exzombie/motokurnikator/door_mechanism.jpg

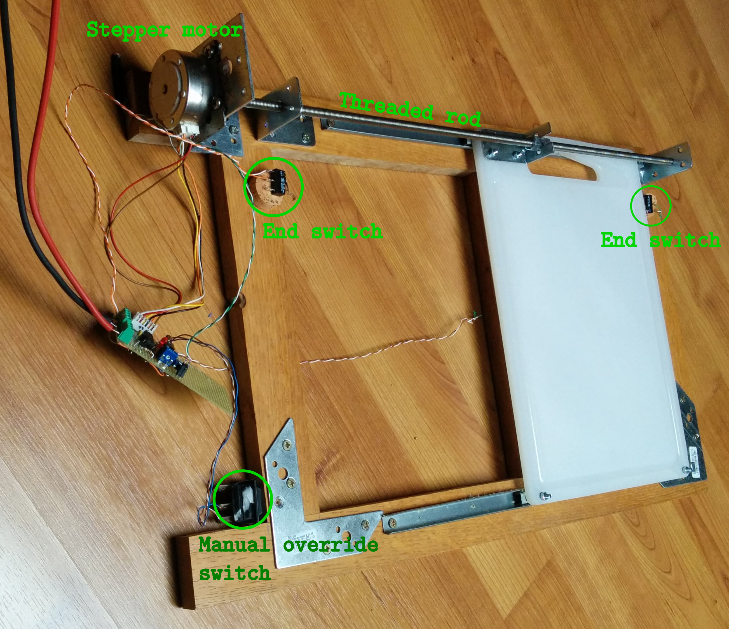
door_mechanism.jpg
