exzombie/motokurnikator/circuit/motokurnikator.sch

## KiCad design circuit/motokurnikator.sch (2018-02-13)

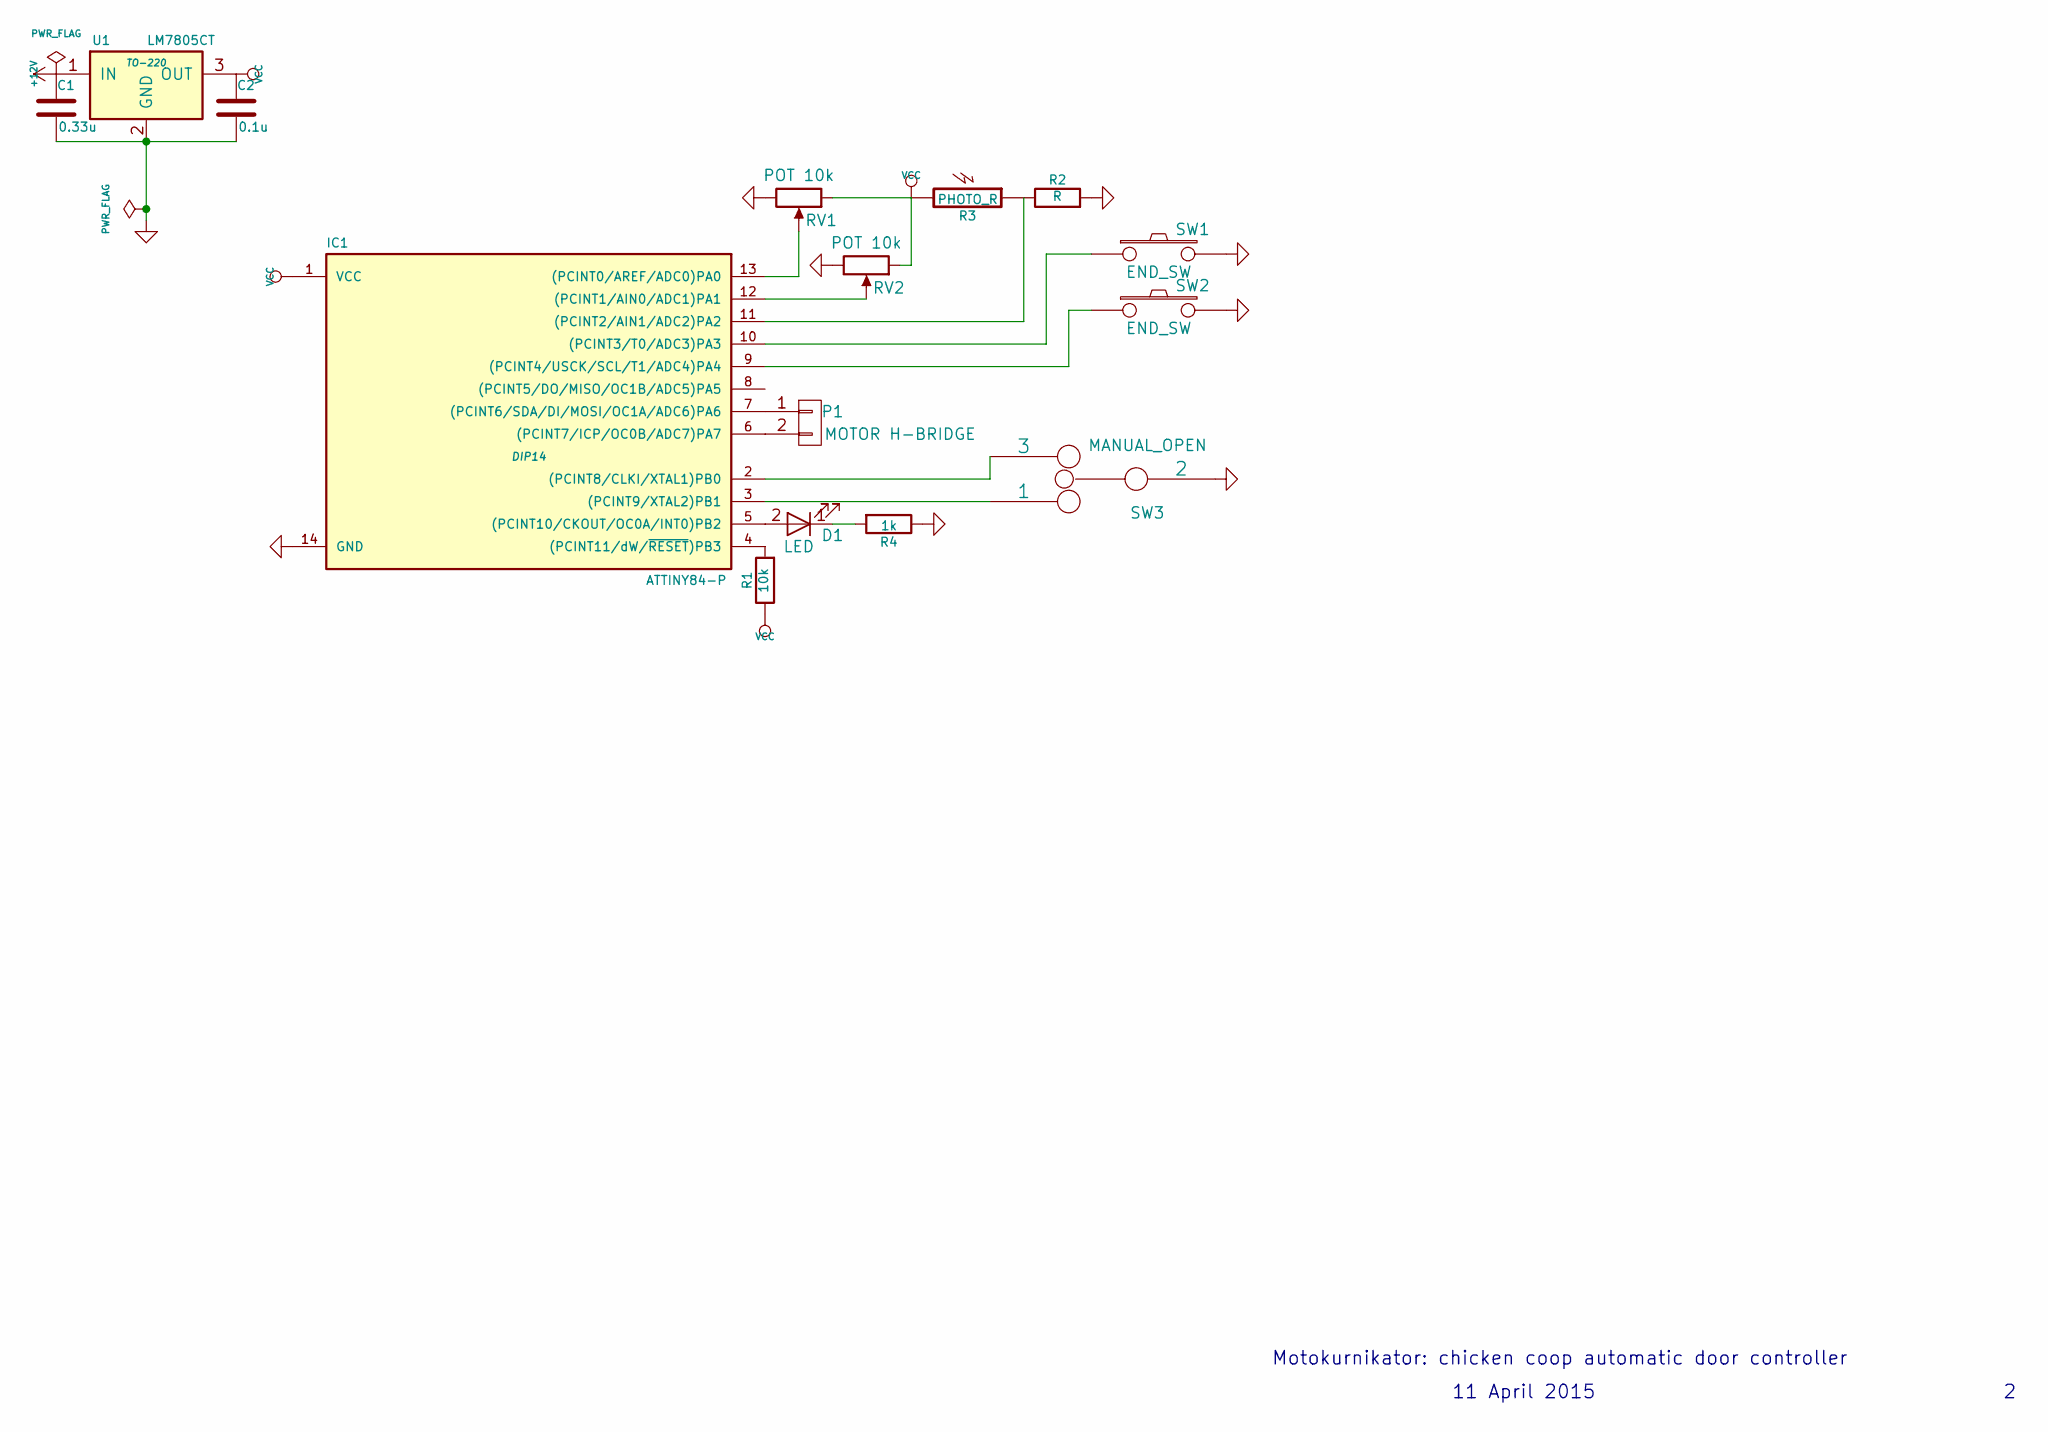
[picture p2: schematic motokurnikator.sch]

Parts:
C1: 0.33u
C2: 0.1u
D1: LED
IC1: ATTINY84-P; DIP14
P1: MOTOR H-BRIDGE
R1: 10k
R2: R
R3: PHOTO_R
R4: 1k
RV1, RV2: POT 10k
SW1, SW2: END_SW
SW3: MANUAL_OPEN
U1: LM7805CT; TO-220

Connections:
+12V: C1.1, U1.1 (IN)
GND: C1.2, C2.2, IC1.14 (GND), R2.2, R4.1, RV1.3, RV2.3, SW1.2, SW2.2, SW3.2, U1.2 (GND)
unnamed: D1.1 (K), R4.2
unnamed: D1.2 (A), IC1.5 ((PCINT10/CKOUT/OC0A/INT0)PB2)
unnamed: IC1.2 ((PCINT8/CLKI/XTAL1)PB0), SW3.3
unnamed: IC1.3 ((PCINT9/XTAL2)PB1), SW3.1
unnamed: IC1.4 ((PCINT11/dW/~RESET~)PB3), R1.2
unnamed: IC1.6 ((PCINT7/ICP/OC0B/ADC7)PA7), P1.2
unnamed: IC1.7 ((PCINT6/SDA/DI/MOSI/OC1A/ADC6)PA6), P1.1
unnamed: IC1.9 ((PCINT4/USCK/SCL/T1/ADC4)PA4), SW2.1
unnamed: IC1.10 ((PCINT3/T0/ADC3)PA3), SW1.1
unnamed: IC1.11 ((PCINT2/AIN1/ADC2)PA2), R2.1, R3.1
unnamed: IC1.12 ((PCINT1/AIN0/ADC1)PA1), RV2.2
unnamed: IC1.13 ((PCINT0/AREF/ADC0)PA0), RV1.2
VCC: C2.1, IC1.1 (VCC), R1.1, R3.2, RV1.1, RV2.1, U1.3 (OUT)

Notes on the sheet:
Motokurnikator: chicken coop automatic door controller
11 April 2015
