exzombie/motokurnikator/(commit log)

2015-04-26 Initial import.
    [motokurnikator.sch]
2015-04-26 Add a missing resistor.
    [motokurnikator.sch]
2015-04-30 Note the fuse settings in the openprogrammer comment.
2015-04-30 Use software reference instead of hw ref. to allow going below 2V.
2018-01-02 Update schematic for newer symbol library.
    [motokurnikator.sch]
2018-01-02 DC motor support.
2018-01-02 Add a timed limit to motor drive.
2018-02-13 Remove support for stepper motors.
    [motokurnikator.sch]
2018-02-13 Replace defines with variables.
    [sketch.ino]
2018-02-13 Replace the remaining Wiring pin operations with FastPin.
    [sketch.ino]
2018-02-13 Use two pots instead of a fixed hysteresis for easier setting.
    [motokurnikator.sch]
2018-05-01 Make motor direction an enum.
